dchayto/DCMR-4W01/overview/DCMR_controller.drawio.png

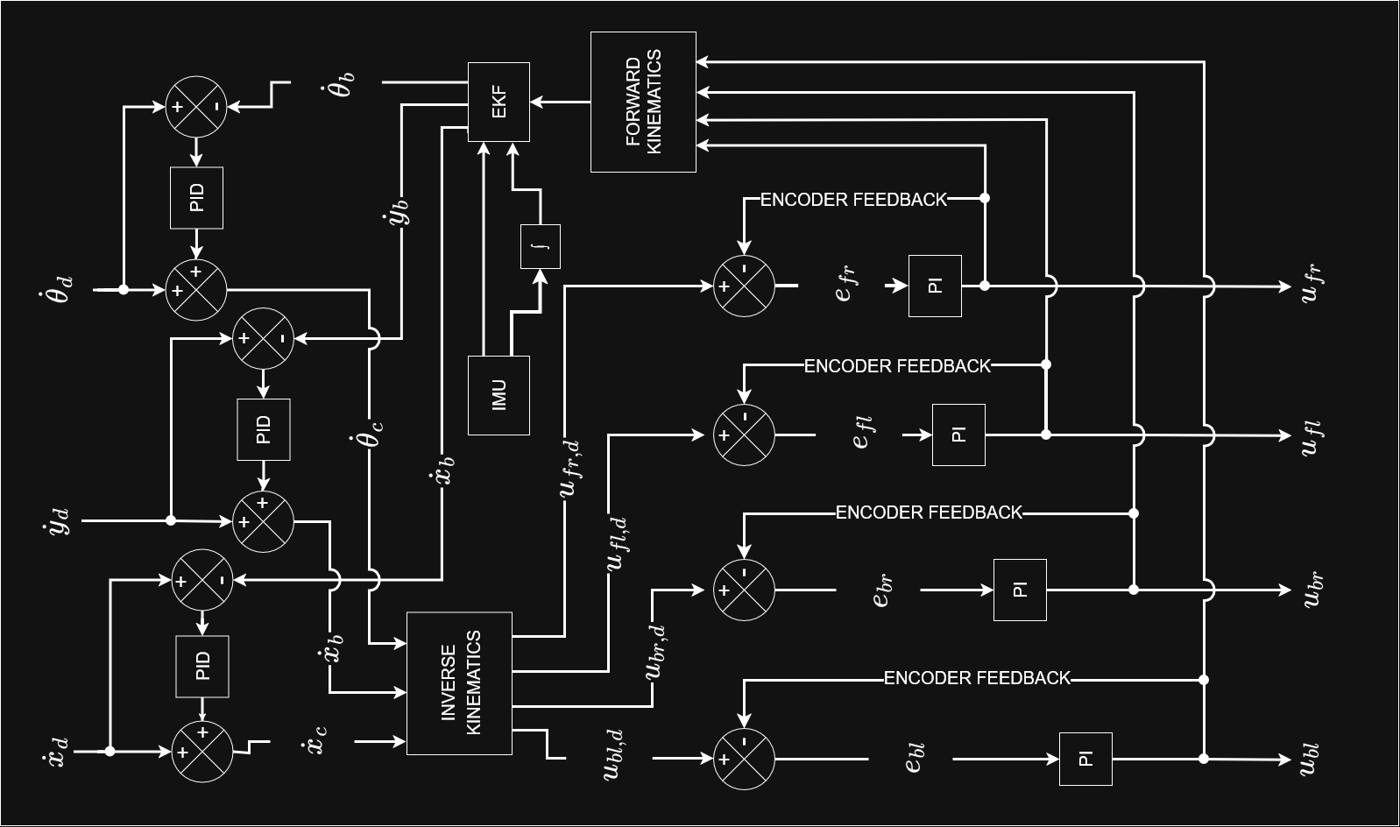
overview/DCMR_controller.drawio.png
