dchayto/DCMR-4W01/due/motor_driver/include/pin_defines.hpp

/* 								pin_defines.hpp								//
	pin definitions for due hookups (GPIO array). probably going to want to 
	change a lot of these when wiring is done

	NOTE: FR is driver 1 motor A,  FL is driver 1 motor B,  BR -> 2B, BL -> 2A

	auth: @dchayto
*/

#ifndef DUE_PIN_DEFINES
#define DUE_PIN DEFINES

// motor PWM signals
constexpr int FR_PWM = 6; 	// GPIO 6 (PWM)	- orange on driver 1
constexpr int FL_PWM = 7;	// GPIO 7 (PWM)	- yellow on driver 1
constexpr int BR_PWM = 8;	// GPIO 8 (PWM)	- yellow on driver 2
constexpr int BL_PWM = 9;	// GPIO 9 (PWM) - orange on driver 2

// half-bridge controls (fwd/reverse)
// NOTE: wired flipped left-right, since driving direction relative to wheel
// direction is inverted
constexpr int FR_FWD = 23;	// 1A, in1 (PURPLE)	
constexpr int FR_REV = 25;	// 1A, in2 (GREY)	

constexpr int FL_FWD = 24;	// 1B, in4 (BLACK)	
constexpr int FL_REV = 22;	// 1B, in3 (WHITE)	

constexpr int BR_FWD = 46;	// 2B, in3 (WHITE)
constexpr int BR_REV = 44;	// 2B, in4 (BLACK)	

constexpr int BL_FWD = 45;	// 2A, in2 (GREY) 
constexpr int BL_REV = 47;	// 2A, in1 (PURPLE)	


// encoder signals (receive)
constexpr int FR_ENCA = 52;	// GREEN
constexpr int FR_ENCB = 53;	// BLUE

constexpr int FL_ENCA = 32;	// GREEN
constexpr int FL_ENCB = 33;	// BLUE

constexpr int BR_ENCA = 50;	// GREEN
constexpr int BR_ENCB = 51;	// BLUE

constexpr int BL_ENCA = 34;	// GREEN
constexpr int BL_ENCB = 35;	// BLUE

// ultrasonic sensor signals
// SET LATER

#endif
