dchayto/DCMR-4W01/(commit log)

2026-01-04 changed UARTmsgs to work with arduino compiler; changed due dir struct to work with arduino compiler; added sleep to test code to allow for due port setup
2026-01-04 modified code to test passing actual messages between boards
2026-01-04 due_hw_interface.cpp updates didn't commit for some reason
    [due_hw_interface.cpp]
2026-04-18 wired motor drivers into robot. updated pin defines to match wiring. moved PID class to common_include (going to reuse for wheel pwm loops)
2026-09-24 rewrote pi:due message serialization and deserialization. added struct/helpers for handling encoder data returned by due. untested as of yet, going to modify hardware interfaces to use new messaging 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
2026-09-26 fixed some logic errors (mismatched floating point rep, calculating payload wire size incorrectly
2026-09-26 fixed some logic errors with serial message passing. modified hardware interfaces for one-sided communications (i.e., allowing wheelspeed messages to pass to due, but no support for returning encoder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
    [due_hw_interface.cpp, kb_input_handler.cpp, mec_wheel_controller.cpp, mec_wheel_controller.hpp, motor_driver.ino]
2026-09-30 fixed logic errors with serial messaging. fixed logic errors with due-side message parsing. wheelspeed messages now transmitting and receiving properly (tested on hardware), to 1mrad quantization.
    [due_hw_interface.cpp, motor_driver.ino]
2026-10-02 roughed out code to handle encoder on due-side (note: just for reading in messages, not processing into measurement for PID loop). also need to do pin defines for encoder lines (waiting until built o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
2026-10-02 updated control package to process wheel travel data returned from due. have not tested yet (still need to build circuit)
2026-10-06 fixes to mec_wheel_controller. changed some naming conventions. changed to rad/s and rad representation until wire layer. other minor changes to input handling.
    [PID.hpp, due_hw_interface.cpp, encoder.hpp, kb_input.hpp, kb_input_handler.cpp, kb_screen_handler.hpp, mec_wheel_controller.cpp, motor_driver.ino]
2026-10-07 fixed issue where due would crash every 6 messages or so - was getting array OOB from sending ring buffer to serialization functions. still looking into why only the first topside message is serializ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
    [due_hw_interface.cpp, motor_driver.ino]
2026-10-07 roughed out wheel odometry handler. changed keyboard handler back to considering s as backwards, x as stop
2026-10-08 added macro for lightweight builds in case pi is struggling. changed imu_handler to python file to use sensor's supported libraries.
2026-10-09 got messaging (seemingly) working - had a couple lingering bugs. added encoder handling (still need to build topside encoder-based state estimator and build in) and tune wheel PIDs. sending wheelspee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
    [due_hw_interface.cpp, encoder.hpp, kb_input_handler.cpp, motor_driver.ino, pin_defines.hpp, wheel_odometry.cpp]
2026-10-10 fixed kb_input_handler - was running into issues with keyboard hold-down delays (command would start, then stop suddenly, then start again - most keyboards have a delay before processing held command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
    [kb_input_handler.cpp]
2026-10-10 moved messages to interface package. fixed logic error in PID.hpp integral handling. fixed some syntax errors in odom handler.
    [PID.hpp, due_hw_interface.cpp, mec_wheel_controller.cpp, motor_driver.ino, wheel_odometry.cpp]
2026-10-11 tuned wheel PIDs. not perfect, but not sure how much better i can get with hardware/mechanical - will look into later.
2026-10-11 added a bit of i-gain based off driving on ground
2026-10-11 renamed URDF package to remove naming conflict with base ros
2026-10-12 added launch support - untested as of now. also added robot_localization to fuse encoder/imu data - also untested as of now
2026-10-14 bug fixes for keyboard input handler, mec wheel controller, PID. still some issues with top-level velocity controller - ekf outputs junk data when sensors drop, and controller and sensor covariance m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
2026-10-15 changed mec_wheel_controller to take in PID values as parameters (wanted to be able to tune without having to build every time). started tuning PID controller - difficult due to high wheel slippage +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
2026-10-17 added CAD image
